electronicBlacksmith/SolArk_Live_Data/hardware/carrier-diy/fab/render_bottom.png

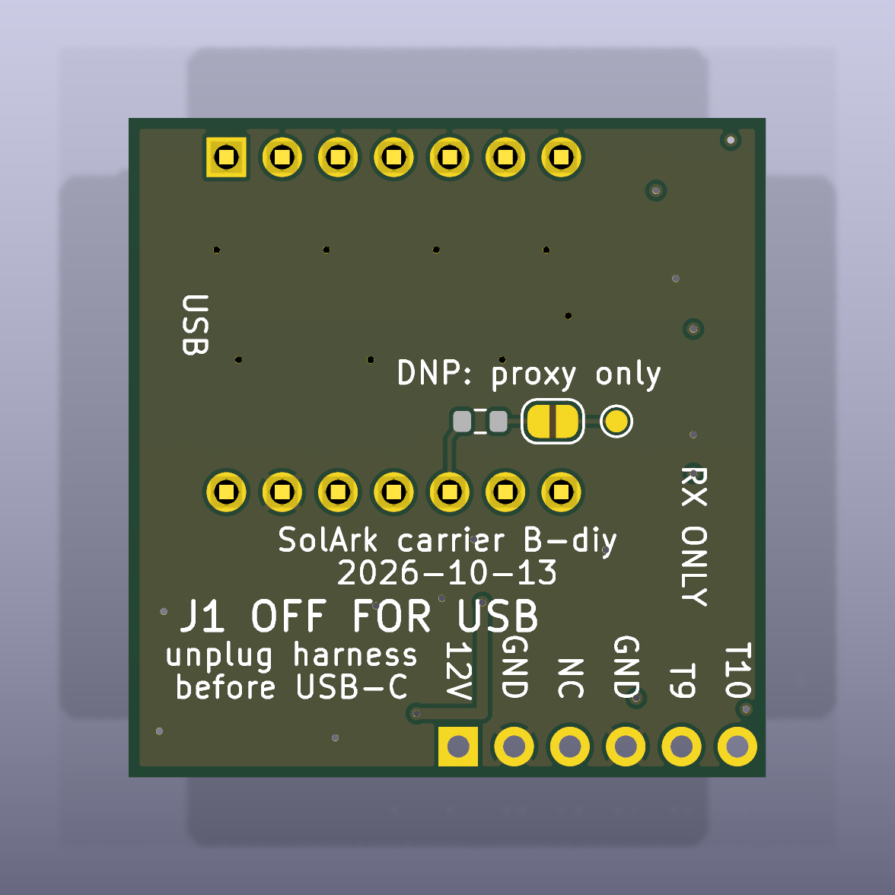
hardware/carrier-diy/fab/render_bottom.png
