electronicBlacksmith/SolArk_Live_Data/hardware/carrier-diy/fab/render_iso.png

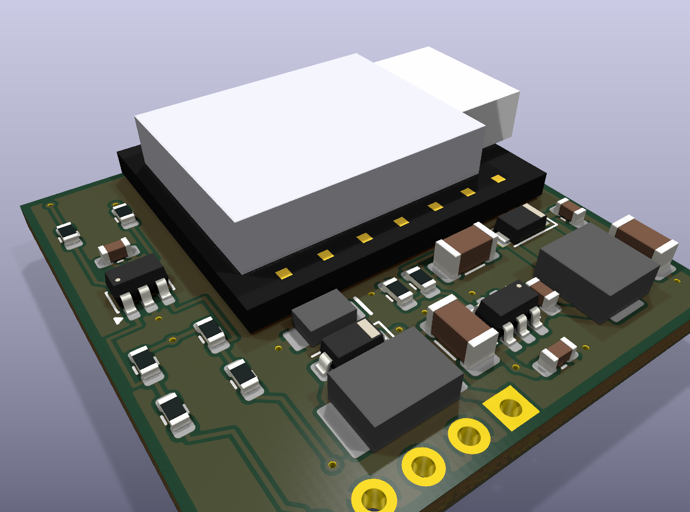
hardware/carrier-diy/fab/render_iso.png
