electronicBlacksmith/SolArk_Live_Data/hardware/carrier-diy/fab/render_side_front.png

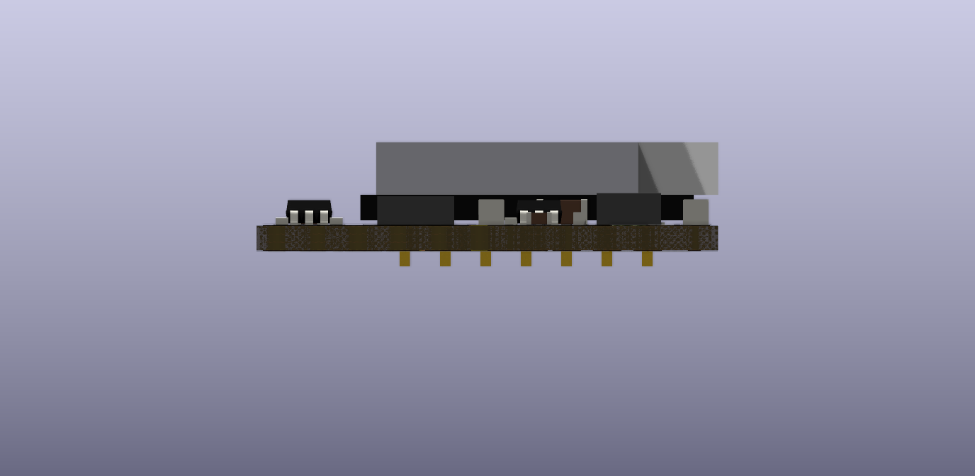
hardware/carrier-diy/fab/render_side_front.png
