electronicBlacksmith/SolArk_Live_Data/hardware/carrier-jlc/fab/render_bottom.png

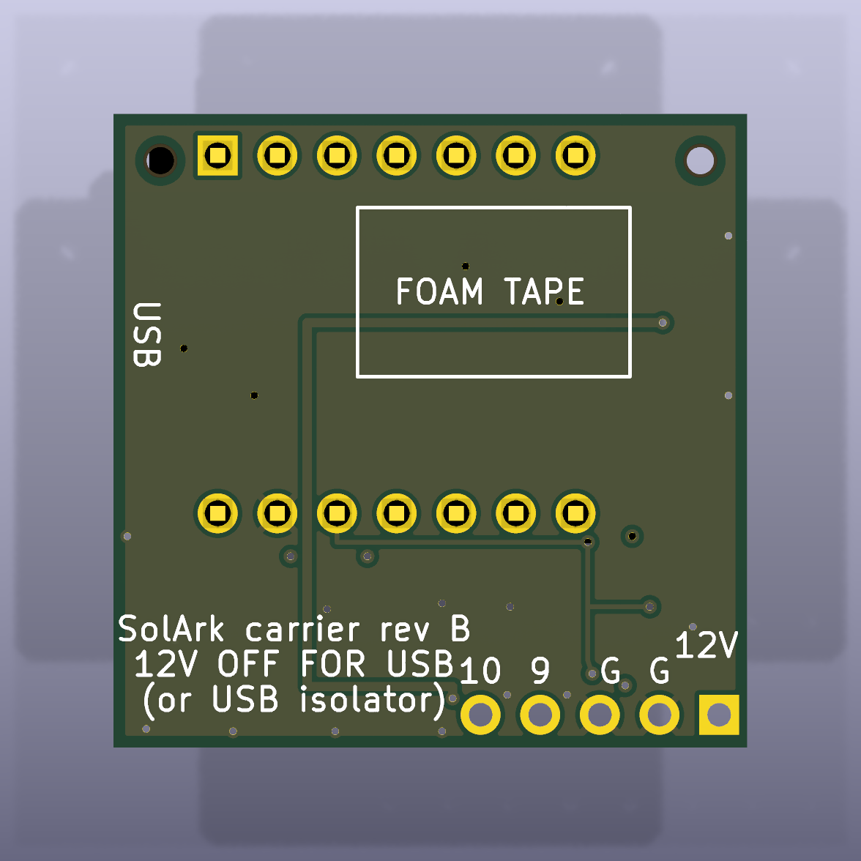
hardware/carrier-jlc/fab/render_bottom.png
