electronicBlacksmith/SolArk_Live_Data/hardware/carrier-jlc/fab/render_iso.png

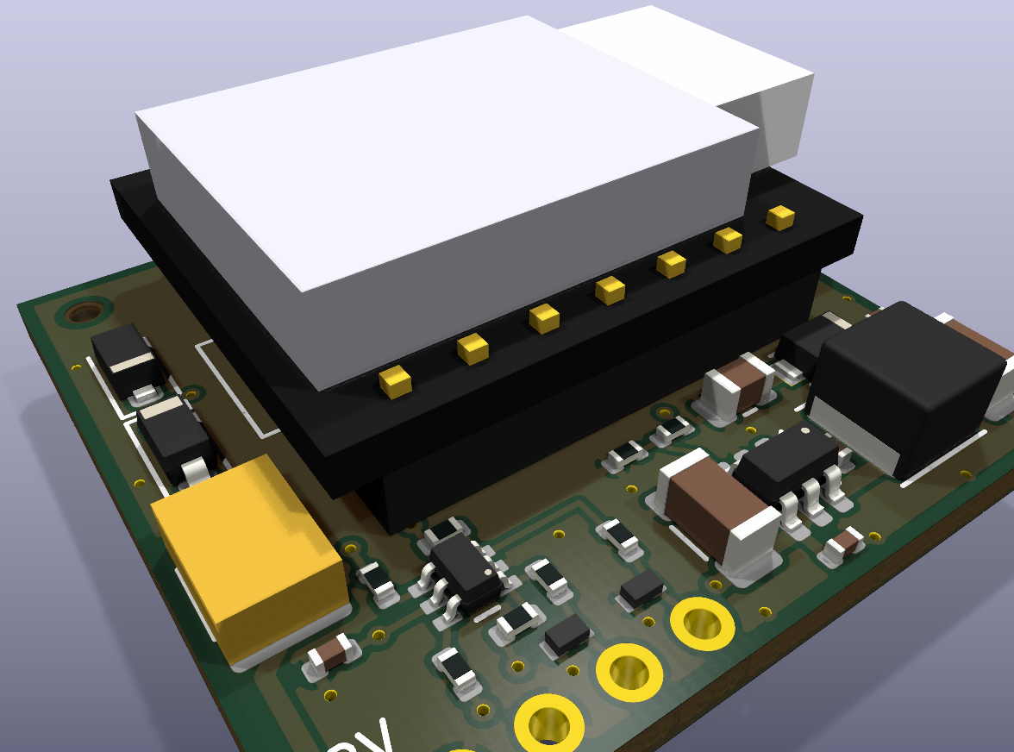
hardware/carrier-jlc/fab/render_iso.png
