electronicBlacksmith/SolArk_Live_Data/hardware/carrier-jlc/fab/render_side_right.png

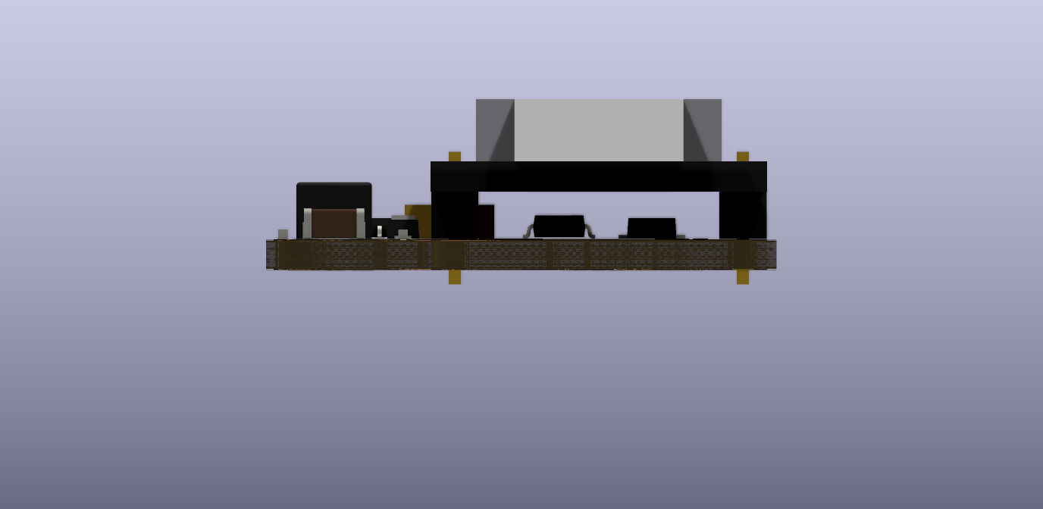
hardware/carrier-jlc/fab/render_side_right.png
