electronicBlacksmith/SolArk_Live_Data/hardware/carrier/fab/render_bottom.png

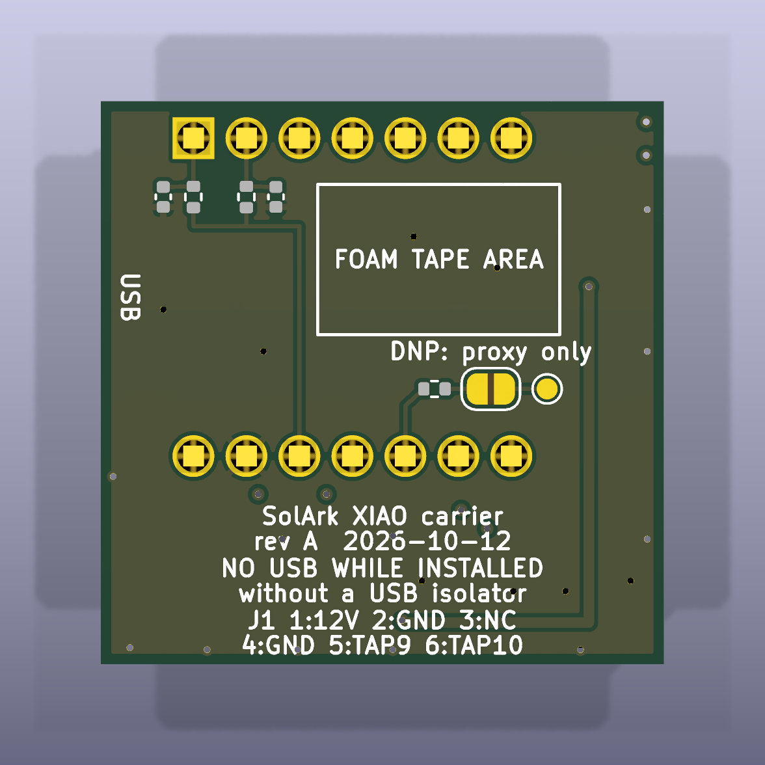
hardware/carrier/fab/render_bottom.png
