electronicBlacksmith/SolArk_Live_Data/hardware/carrier/fab/render_iso.png

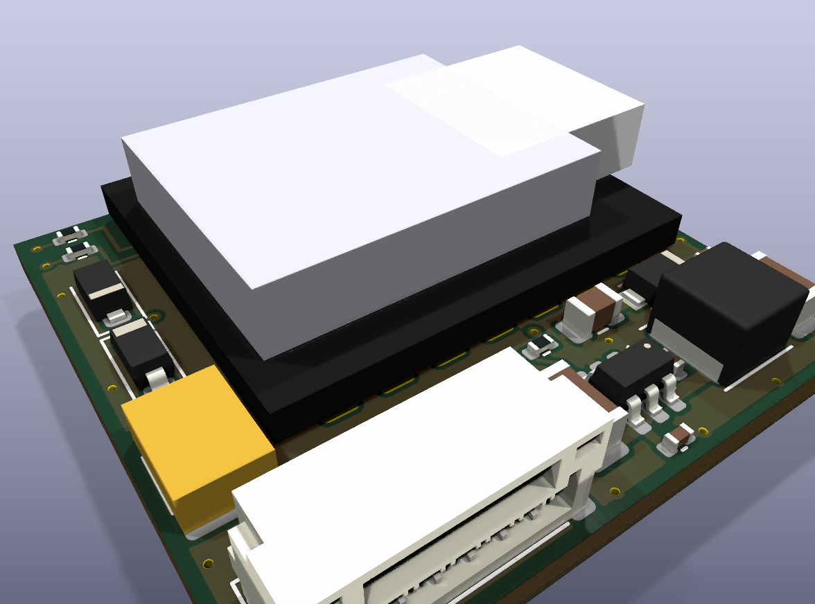
hardware/carrier/fab/render_iso.png
