electronicBlacksmith/SolArk_Live_Data/hardware/carrier/fab/render_side_right.png

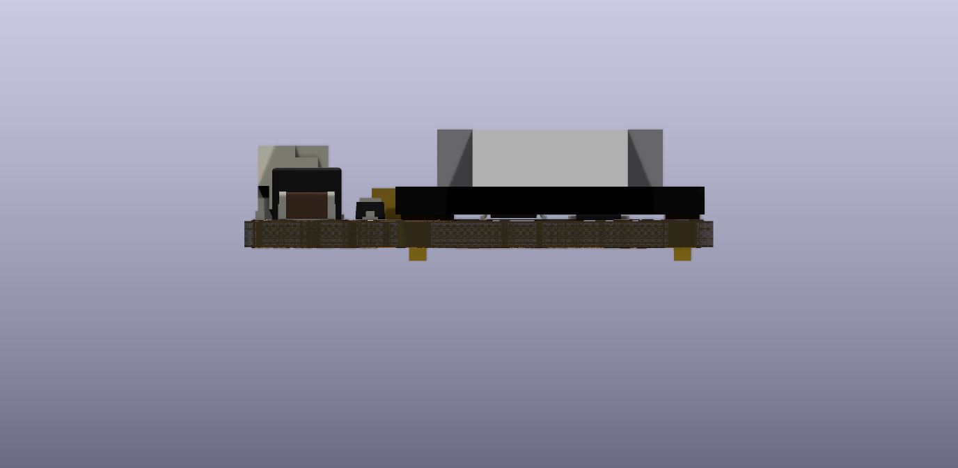
hardware/carrier/fab/render_side_right.png
