electronicBlacksmith/SolArk_Live_Data/hardware/carrier-diy/fab/carrier_bom_digikey.csv

Digi-Key PN | MPN | Qty per board | Designators | Value | Footprint | Route (a) fit
118-MF-MSMF050/60X-2CT-ND | Bourns MF-MSMF050/60X-2 | 1 | F1 | 0.5A 60V PPTC | Fuse_1812_Bourns_MF-MSMF | hand
B5819W-TPMSCT-ND | MCC B5819W-TP (JLC: CJ B5819W C8598) | 1 | D1 | B5819W | D_SOD-123 | jlc
F5820CT-ND | Littelfuse SMF18A | 1 | TVS1 | SMF18A | D_SOD-123FL_Littelfuse_SMF | hand
13-CC1206KKX5R9BB106CT-ND | Yageo CC1206KKX5R9BB106 (JLC: Samsung CL31A106KBHNNNE) | 1 | C1 | 10uF 50V | C_1206_3216Metric | jlc
311-1344-1-ND | Yageo CC0603KRX7R9BB104 | 4 | C2,C8,C4,C9 | 100nF 50V | C_0603_1608Metric | jlc
296-LMR51610YDBVRCT-ND | TI LMR51610YDBVR | 1 | U2 | LMR51610YDBVR | SOT-23-6_TI_DBV0006A | hand
SRP4020TA-100MCT-ND | Bourns SRP4020TA-100M | 1 | L1 | 10uH | L_Bourns_SRP4020TA | hand
587-3246-1-ND | Taiyo Yuden TMK316BBJ226ML-T | 1 | C7 | 22uF 25V | C_1206_3216Metric | hand
P20.5KDBCT-ND | Panasonic ERA-3AEB2052V | 1 | R13 | 20.5k 0.1% | R_0603_1608Metric | hand
P3.83KDBCT-ND | Panasonic ERA-3AEB3831V | 1 | R14 | 3.83k 0.1% | R_0603_1608Metric | hand
1727-5313-1-ND | Nexperia PMEG4030ER,115 | 1 | D2 | PMEG4030ER | Nexperia_CFP3_SOD-123W | hand
445-6008-1-ND | TDK C3216X5R0J107M160AB (JLC: Samsung CL31A107MQHNNNE) | 1 | C3 | 100uF 6.3V | C_1206_3216Metric | jlc
311-1.00KHRCT-ND | Yageo RC0603FR-071KL (JLC: Uniroyal 0603WAF1001T5E) | 4 | R3,R4,R7,R8 | 1k | R_0603_1608Metric | jlc
311-100KHRCT-ND | Yageo RC0603FR-07100KL (JLC: Uniroyal 0603WAF1003T5E) | 2 | R5,R6 | 100k | R_0603_1608Metric | jlc
296-SN74LVC2G17DBVRCT-ND | TI SN74LVC2G17DBVR | 1 | U3 | SN74LVC2G17DBVR | SOT-23-6_TI_DBV0006A | hand
S1011EC-40-ND | Sullins PRPC040SAAN-RC | 2x7 pins | - | U1 mount: 0.64 mm square header pins, plastic removed after soldering | - | kit
S7004-ND | Sullins PPTC061LFBN-RC | 1 | - | Harness in-line plug (female); mates with a 6-pin PRPC040 section (plastic kept) on the J1 wires | - | kit
CF18JT10K0CT-ND | Stackpole CF18JT10K0 | 2 | - | REQUIRED harness series 10 k, 1/8 W axial: one in each tap wire, at the dongle pad 9 and pad 10 ends | - | kit
