electronicBlacksmith/SolArk_Live_Data/hardware/carrier-diy/fab/carrier_bom_jlc.csv

Comment | Designator | Footprint | LCSC Part #
10uF 50V | C1 | Capacitor_SMD:C_1206_3216Metric | C13585
100nF 50V | C2,C4,C8,C9 | Capacitor_SMD:C_0603_1608Metric | C14663
100uF 6.3V | C3 | Capacitor_SMD:C_1206_3216Metric | C15008
B5819W | D1 | Diode_SMD:D_SOD-123 | C8598
1k | R3,R4,R7,R8 | Resistor_SMD:R_0603_1608Metric | C21190
100k | R5,R6 | Resistor_SMD:R_0603_1608Metric | C25803
