electronicBlacksmith/SolArk_Live_Data/hardware/carrier-jlc/fab/carrier_bom_jlc.csv

Comment | Designator | Footprint | LCSC Part #
10uF 50V | C1 | Capacitor_SMD:C_1206_3216Metric | C13585
100nF 50V | C2,C4,C8,C9 | Capacitor_SMD:C_0402_1005Metric | C307331
100uF 6.3V | C3 | Capacitor_SMD:C_1206_3216Metric | C15008
22uF 25V | C7 | Capacitor_SMD:C_0805_2012Metric | C45783
B5819W | D1 | Diode_SMD:D_SOD-123 | C8598
PMEG4030ER | D2 | Diode_SMD:Nexperia_CFP3_SOD-123W | C389355
H5VL10B | D3,D4 | carrier:DFN1006-2L_H5VL10B | C7420372
0.5A 60V PPTC | F1 | Fuse:Fuse_1812_4532Metric | C462518
10uH 1.6A | L1 | Inductor_SMD:L_Changjiang_FNR4030S | C167879
1k | R3,R4,R7,R8 | Resistor_SMD:R_0402_1005Metric | C11702
100k | R5,R6 | Resistor_SMD:R_0402_1005Metric | C25741
33k 0.1% 25ppm | R13 | Resistor_SMD:R_0402_1005Metric | C728559
6.19k 0.1% 25ppm | R14 | Resistor_SMD:R_0402_1005Metric | C705638
SMF18A | TVS1 | Diode_SMD:D_SOD-123F | C19077512
LMR51610YDBVR | U2 | Package_TO_SOT_SMD:SOT-23-6 | C22427220
74LVC2G17GW | U3 | carrier:SOT363-2_Nexperia | C80500
