electronicBlacksmith/SolArk_Live_Data/hardware/carrier-diy/carrier.kicad_pcb

## KiCad design hardware/carrier-diy/carrier.kicad_pcb (2026-10-15)

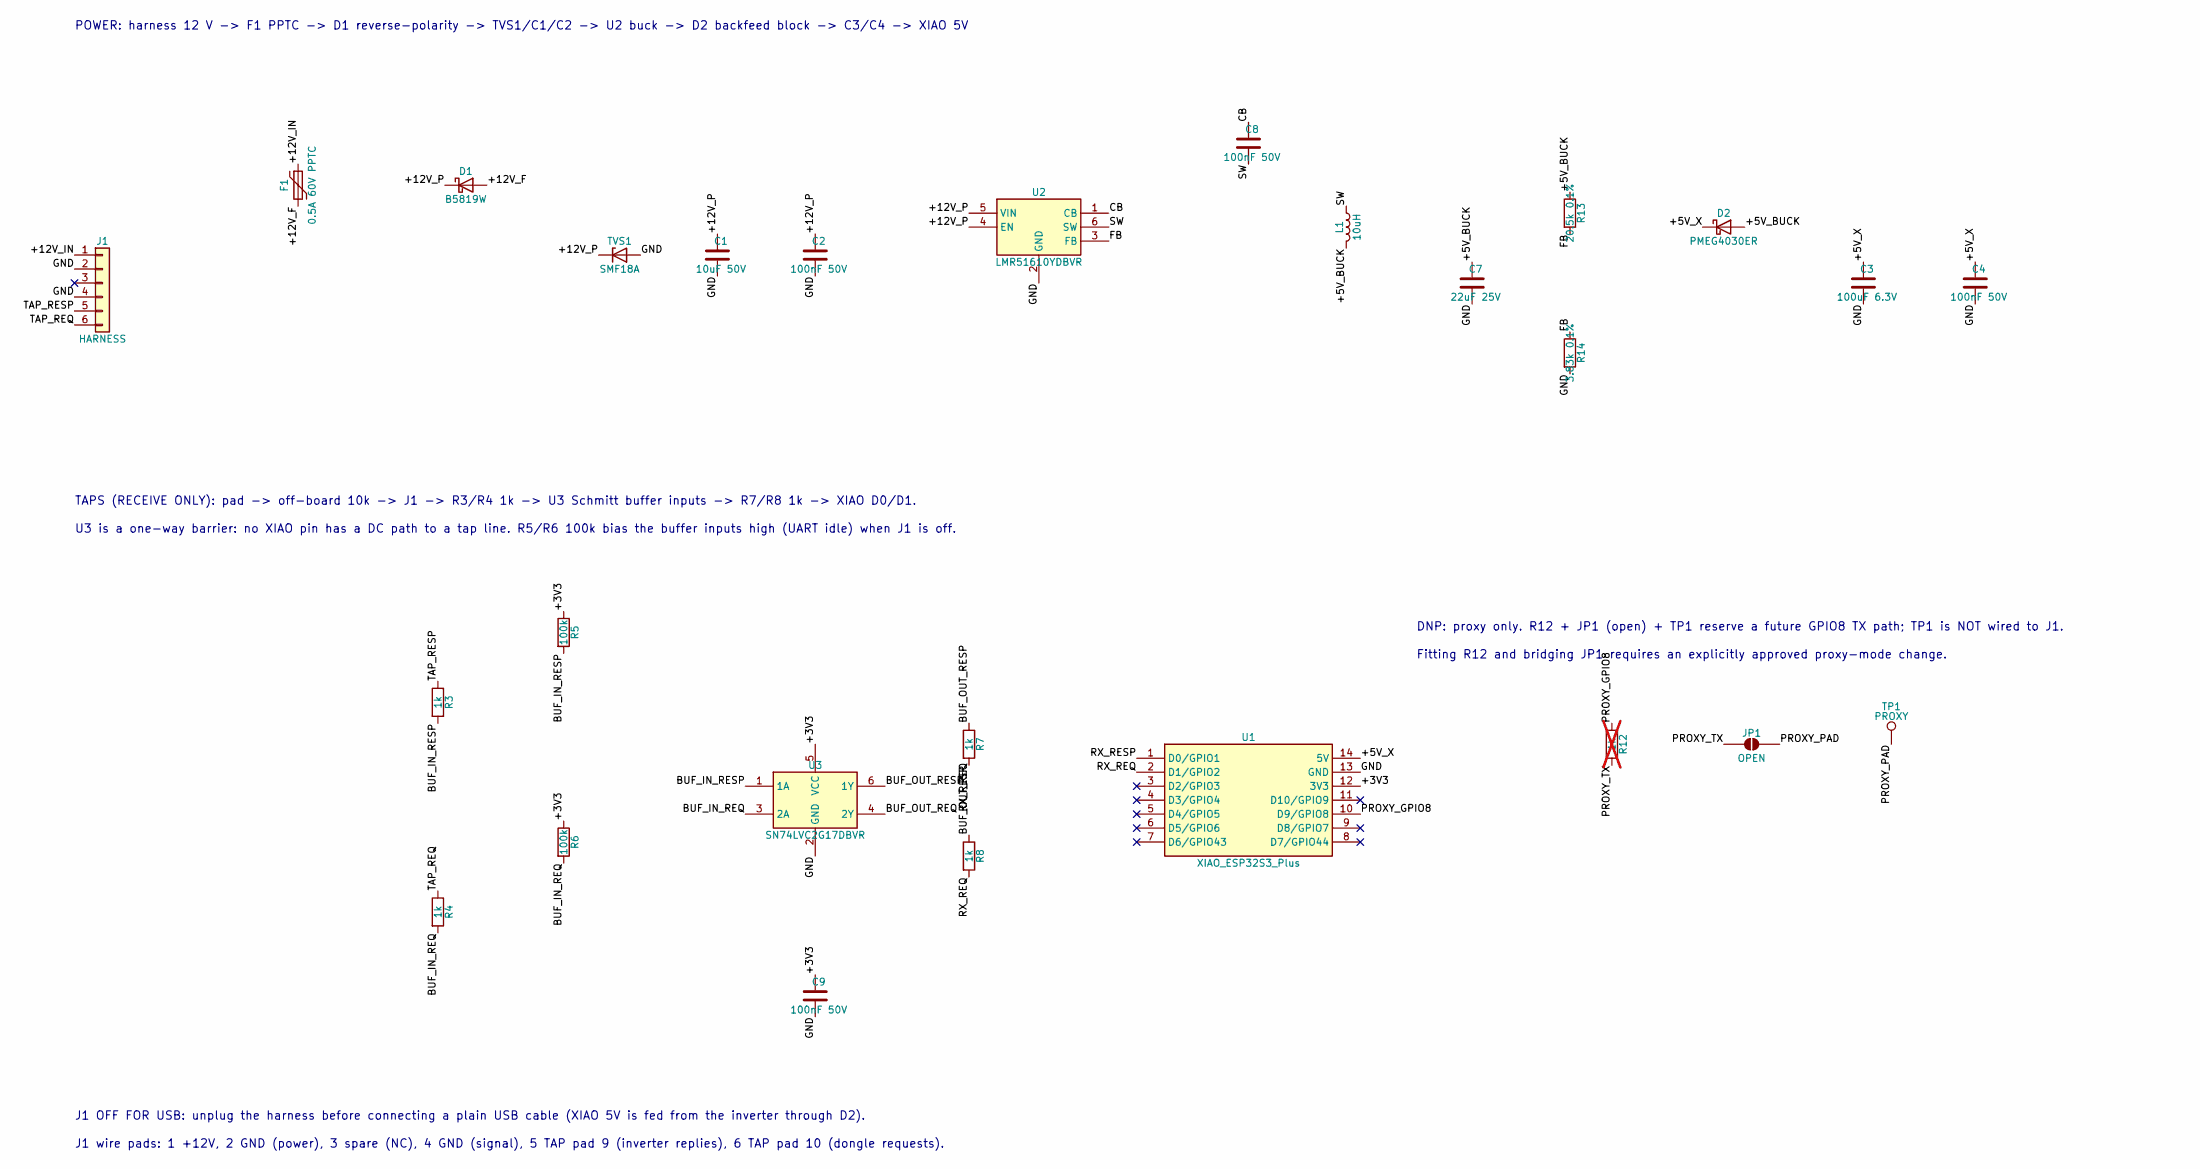
[picture p16: schematic carrier.kicad_sch, SolArk XIAO tap carrier]

Parts:
C1: 10uF 50V; C_1206_3216Metric; LCSC C13585
C2, C4, C8, C9: 100nF 50V; C_0603_1608Metric; LCSC C14663
C3: 100uF 6.3V; C_1206_3216Metric; LCSC C15008
C7: 22uF 25V; C_1206_3216Metric
D1: B5819W; D_SOD-123; LCSC C8598
D2: PMEG4030ER; Nexperia_CFP3_SOD-123W
F1: 0.5A 60V PPTC; Fuse_1812_Bourns_MF-MSMF
J1: HARNESS; WirePads_1x06_P2.54
JP1: OPEN; SolderJumper-2_P1.3mm_Open_RoundedPad1.0x1.5mm
L1: 10uH; L_Bourns_SRP4020TA
R3, R4, R7, R8: 1k; R_0603_1608Metric; LCSC C21190
R5, R6: 100k; R_0603_1608Metric; LCSC C25803
R12: 1k; R_0603_1608Metric; LCSC C21190; not fitted
R13: 20.5k 0.1%; R_0603_1608Metric
R14: 3.83k 0.1%; R_0603_1608Metric
TP1: PROXY; TestPoint_Pad_D1.0mm
TVS1: SMF18A; D_SOD-123FL_Littelfuse_SMF
U1: XIAO_ESP32S3_Plus; XIAO_ESP32S3_Header_THT
U2: LMR51610YDBVR; SOT-23-6_TI_DBV0006A
U3: SN74LVC2G17DBVR; SOT-23-6_TI_DBV0006A

Connections:
/+3V3: C9.1, R5.1, R6.1, U1.12 (3V3), U3.5 (VCC)
/+5V_BUCK: C7.1, D2.2 (A), L1.2, R13.1
/+5V_X: C3.1, C4.1, D2.1 (K), U1.14 (5V)
/+12V_F: D1.2 (A), F1.2
/+12V_IN: F1.1, J1.1
/+12V_P: C1.1, C2.1, D1.1 (K), TVS1.1 (K), U2.4 (EN), U2.5 (VIN)
/BUF_IN_REQ: R4.2, R6.2, U3.3 (2A)
/BUF_IN_RESP: R3.2, R5.2, U3.1 (1A)
/BUF_OUT_REQ: R8.1, U3.4 (2Y)
/BUF_OUT_RESP: R7.1, U3.6 (1Y)
/CB: C8.1, U2.1 (CB)
/FB: R13.2, R14.1, U2.3 (FB)
/GND: C1.2, C2.2, C3.2, C4.2, C7.2, C9.2, J1.2, J1.4, R14.2, TVS1.2 (A), U1.13 (GND), U2.2 (GND), U3.2 (GND)
/PROXY_GPIO8: R12.1, U1.10 (D9/GPIO8)
/PROXY_PAD: JP1.2 (B), TP1.1
/PROXY_TX: JP1.1 (A), R12.2
/RX_REQ: R8.2, U1.2 (D1/GPIO2)
/RX_RESP: R7.2, U1.1 (D0/GPIO1)
/SW: C8.2, L1.1, U2.6 (SW)
/TAP_REQ: J1.6, R4.1
/TAP_RESP: J1.5, R3.1

Notes on the sheet:
POWER: harness 12 V -> F1 PPTC -> D1 reverse-polarity -> TVS1/C1/C2 -> U2 buck -> D2 backfeed block -> C3/C4 -> XIAO 5V
TAPS (RECEIVE ONLY): pad -> off-board 10k -> J1 -> R3/R4 1k -> U3 Schmitt buffer inputs -> R7/R8 1k -> XIAO D0/D1.
U3 is a one-way barrier: no XIAO pin has a DC path to a tap line. R5/R6 100k bias the buffer inputs high (UART idle) when J1 is off.
DNP: proxy only. R12 + JP1 (open) + TP1 reserve a future GPIO8 TX path; TP1 is NOT wired to J1.
Fitting R12 and bridging JP1 requires an explicitly approved proxy-mode change.
J1 OFF FOR USB: unplug the harness before connecting a plain USB cable (XIAO 5V is fed from the inverter through D2).
J1 wire pads: 1 +12V, 2 GND (power), 3 spare (NC), 4 GND (signal), 5 TAP pad 9 (inverter replies), 6 TAP pad 10 (dongle requests).

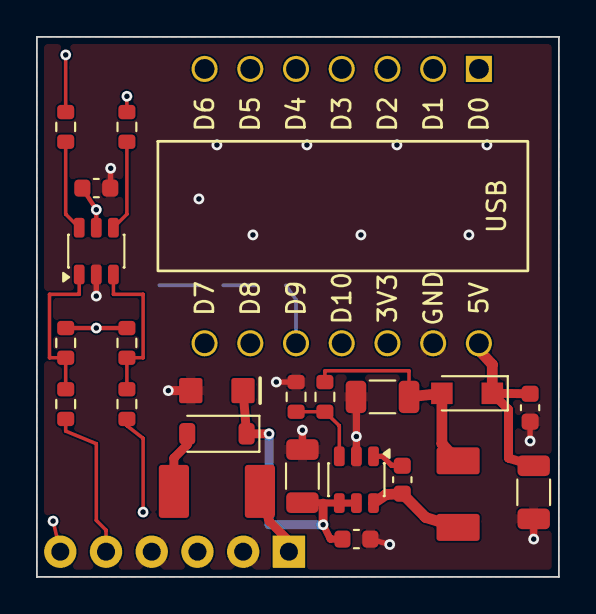
[picture p17: board carrier.kicad_pcb from above]

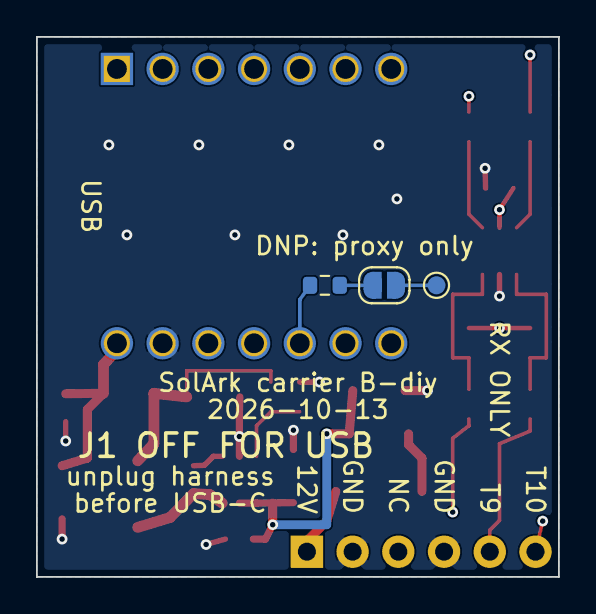
[picture p18: board carrier.kicad_pcb from below]

Board: 4 copper layers, 29.0 x 30.0 mm, 27 parts (3 on the bottom side), 21 nets.
