electronicBlacksmith/SolArk_Live_Data/(commit log)

2026-10-15 docs: capture tooling, link findings, and XIAO firmware design
    - tools/: Saleae Logic 2 capture script and offline UART/Modbus analyzer
    (baud/framing detection, glitch filter, CRC, request/reply pairing)
    - docs/serial-link-findings.md: dongle link verified as Modbus RTU 9600 8N1,
    dongle master, slave 1; module header pinout; poll list and intervals
    - docs/plans/2026-10-11-xiao-firmware-design.md: approved Rust/esp-idf-svc
    firmware design (portable HAL, config-everything, security, TDD)
    - CLAUDE.md: standing project rules
    - .gitignore: keep raw captures (contain inverter serial) and venv out of git
    Claude-Session: https://claude.a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
2026-10-15 docs: 15-minute capture confirms poll schedule; capture.py stops on interrupt
    - 900 s capture: same 11 blocks, 510/510 paired, 100% CRC, no writes;
    op:2/op:3 config items (regs 42-47) are not periodic polls
    - capture.py: Ctrl-C/SIGTERM now stops the Logic 2 recording and saves
    the partial capture instead of leaving Logic 2 recording
    Claude-Session: https://claude.ai/code/session_014AvxNy6zm946nGmLqfYGFg
2026-10-15 docs: power-cycle capture — boot read, clock-sync write, console leaks Wi-Fi creds
    - Dongle writes inverter clock (fc16 regs 22-24, YY MM DD hh mm ss),
    verified against capture wall-clock; design adds a writes topic
    - Boot-only read of regs 0-29; truncated frame on power loss
    - Dongle firmware identity from boot log (R0.7.0.283, built Oct 15 2025)
    - Console prints Wi-Fi credentials at boot: captures treated as secrets
    - capture.py: --label option for tagged capture folders
    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
2026-10-15 docs: pre-plan research (register map, hardware, toolchain, prior art) and build package
    Research notes in docs/research/, hardware build package (schematic, BOM,
    wiring, measurement gates) in docs/hardware/, and pre-plan decisions
    (v6 spike first, server-side DB writer, store-and-forward backfill,
    verified XIAO chip facts) appended to the firmware design.
2026-10-15 feat(hardware): Rev B XIAO carriers (Board A JLC, Board B OSH Park) and research
    - hardware/carrier-jlc: Board A, JLC 4-layer + Economic PCBA; fab rules in
    design.py, silk trimming/checker, customer tooling holes; 31 tests pass.
    - hardware/carrier-diy: Board B, OSH Park bare board + Digi-Key kit; 25 tests.
    - hardware/carrier: Rev A with review synthesis; VERIFY-revB.md independent check.
    - docs/research: dfm-tools, pcb-skills, idf-v6 spike notes (Wi-Fi SSID
    redacted to <IoT SSID> per the leak-check hook).
    - spikes/esp-idf-v6: Wi-Fi/MQTT/TLS spike (credentials via build env only).
    [carrier-B_Cu.gbl, carrier-B_Mask.gbs, carrier-B_Paste.gbp, carrier-B_Silkscreen.gbo, carrier-Edge_Cuts.gm1, carrier-F_Cu.gtl, carrier-F_Mask.gts, carrier-F_Paste.gtp]
2026-10-15 docs(carrier-jlc): record measurements and order (2026-10-14)
    XIAO Plus 4.52 mm (spacer off + Kapton shim), cavity ~31x31x9 mm,
    tap VCC 3.278 V, DB9 12.098 V (TVS1 stays SMF18A). Board A ordered:
    5 assembled, Economic PCBA.
