electronicBlacksmith/SolArk_Live_Data/(notices)

Notices in the files:
parts and their libraries:
XIAO ESP32S3 (Plus) on 2.54 mm male headers (0.64 mm square posts): drill 1.1 / pad 1.7. Pin positions from Seeed XIAO-ESP32-S3-DIP (CC BY-SA 4.0).
